kiyochii/SensoPianoV2/Quartus/PINAGEM.md

# Pinagem proposta — DE0-CV

Confira a montagem externa antes de programar. Todas as entradas/saidas usam 3,3 V.
A numeracao D do GPIO e o indice de sinal, nao o numero fisico no conector de 40 pinos.

| Porta | Pino FPGA |
| --- | --- |
| `CLOCK_50` | `M9` |
| `KEY[0]` | `U7` |
| `KEY[1]` | `W9` |
| `SW0` | `U13` |
| `LEDR[0]` | `AA2` |
| `LEDR[1]` | `AA1` |
| `LEDR[2]` | `W2` |
| `LEDR[3]` | `Y3` |
| `LEDR[4]` | `N2` |
| `LEDR[5]` | `N1` |
| `LEDR[6]` | `U2` |
| `LEDR[7]` | `U1` |
| `LEDR[8]` | `L2` |
| `LEDR[9]` | `L1` |
| `piano_keys[0]` | `N16` |
| `piano_leds_n[0]` | `R21` |
| `rgb_r_n[0]` | `H16` |
| `rgb_g_n[0]` | `J19` |
| `rgb_b_n[0]` | `E15` |
| `piano_keys[1]` | `B16` |
| `piano_leds_n[1]` | `T22` |
| `rgb_r_n[1]` | `A12` |
| `rgb_g_n[1]` | `G11` |
| `rgb_b_n[1]` | `E16` |
| `piano_keys[2]` | `M16` |
| `piano_leds_n[2]` | `N20` |
| `rgb_r_n[2]` | `H15` |
| `rgb_g_n[2]` | `H10` |
| `rgb_b_n[2]` | `F14` |
| `piano_keys[3]` | `C16` |
| `piano_leds_n[3]` | `N19` |
| `rgb_r_n[3]` | `B12` |
| `rgb_g_n[3]` | `J11` |
| `rgb_b_n[3]` | `F15` |
| `piano_keys[4]` | `D17` |
| `piano_leds_n[4]` | `M22` |
| `rgb_r_n[4]` | `A13` |
| `rgb_g_n[4]` | `H14` |
| `rgb_b_n[4]` | `F13` |
| `piano_keys[5]` | `K20` |
| `piano_leds_n[5]` | `P19` |
| `rgb_r_n[5]` | `B13` |
| `rgb_g_n[5]` | `A15` |
| `rgb_b_n[5]` | `F12` |
| `piano_keys[6]` | `K21` |
| `piano_leds_n[6]` | `L22` |
| `rgb_r_n[6]` | `C13` |
| `rgb_g_n[6]` | `J13` |
| `rgb_b_n[6]` | `G16` |
| `piano_keys[7]` | `K22` |
| `piano_leds_n[7]` | `P17` |
| `rgb_r_n[7]` | `D13` |
| `rgb_g_n[7]` | `L8` |
| `rgb_b_n[7]` | `G15` |
| `piano_keys[8]` | `M20` |
| `piano_leds_n[8]` | `P16` |
| `rgb_r_n[8]` | `G18` |
| `rgb_g_n[8]` | `A14` |
| `rgb_b_n[8]` | `G13` |
| `piano_keys[9]` | `M21` |
| `piano_leds_n[9]` | `M18` |
| `rgb_r_n[9]` | `G17` |
| `rgb_g_n[9]` | `B15` |
| `rgb_b_n[9]` | `G12` |
| `piano_keys[10]` | `N21` |
| `piano_leds_n[10]` | `L18` |
| `rgb_r_n[10]` | `H18` |
| `rgb_g_n[10]` | `C15` |
| `rgb_b_n[10]` | `J17` |
| `piano_keys[11]` | `R22` |
| `piano_leds_n[11]` | `L17` |
| `rgb_r_n[11]` | `J18` |
| `rgb_g_n[11]` | `E14` |
| `rgb_b_n[11]` | `K16` |
| `esp_txd` | `L19` |
| `pc_txd` | `K17` |
| `audio_pwm` | `K19` |
| `SW1` (debug C4) | `V13` |
