kiyochii/SensoPianoV2/(commit log)

2026-11-03 test: adiciona progresso à simulação UART e desativa buffer de saída
2026-11-10 Adiciona projeto Quartus para a placa DE0-CV
2026-11-10 Adiciona modo debug C4 para DE0-CV
